pauldevine/pico_v9k/hardware/Victor9K_pga2350.kicad_pcb

## KiCad design hardware/Victor9K_pga2350.kicad_pcb (2026-02-09)

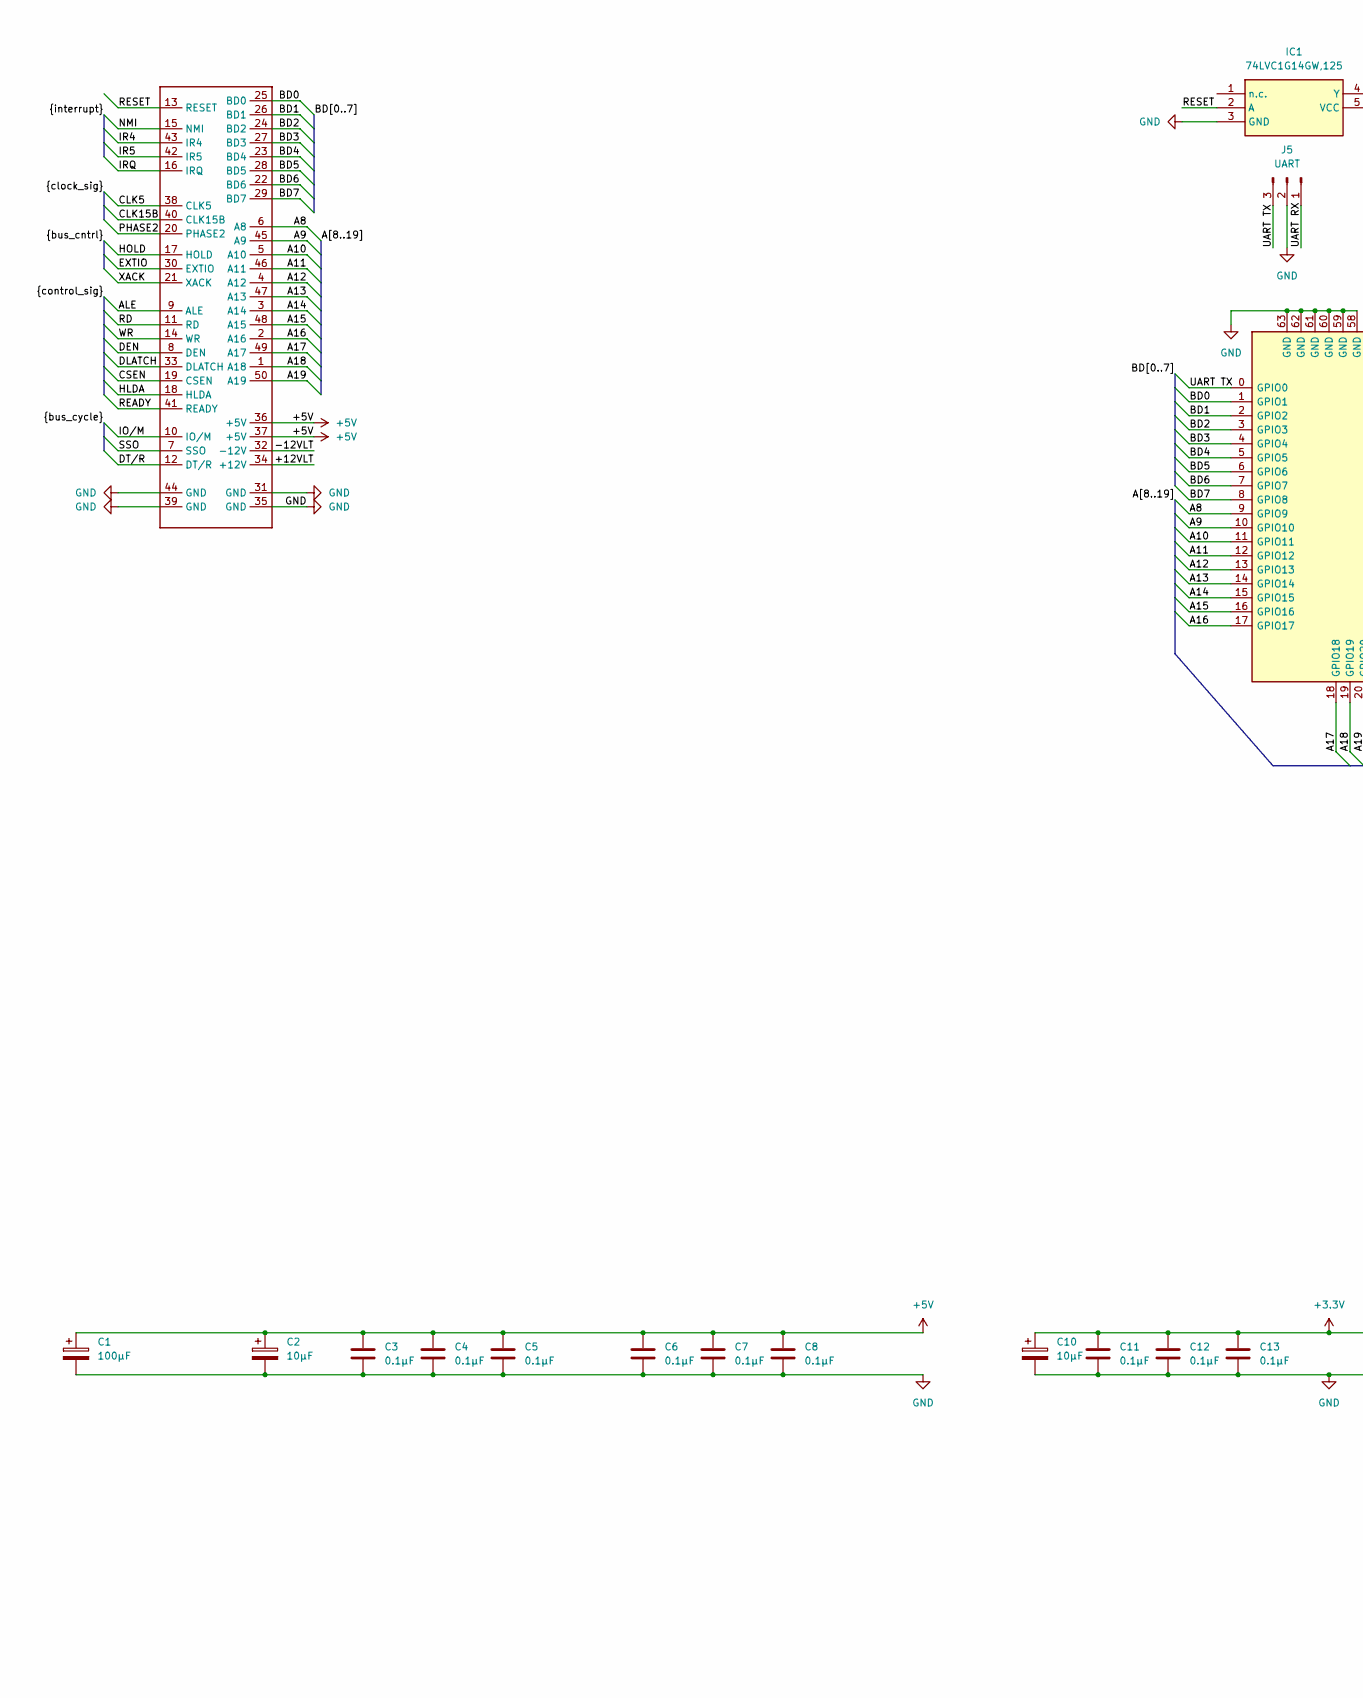
[picture p1: schematic Victor9K_pga2350.kicad_sch, part in row 1, column 1]

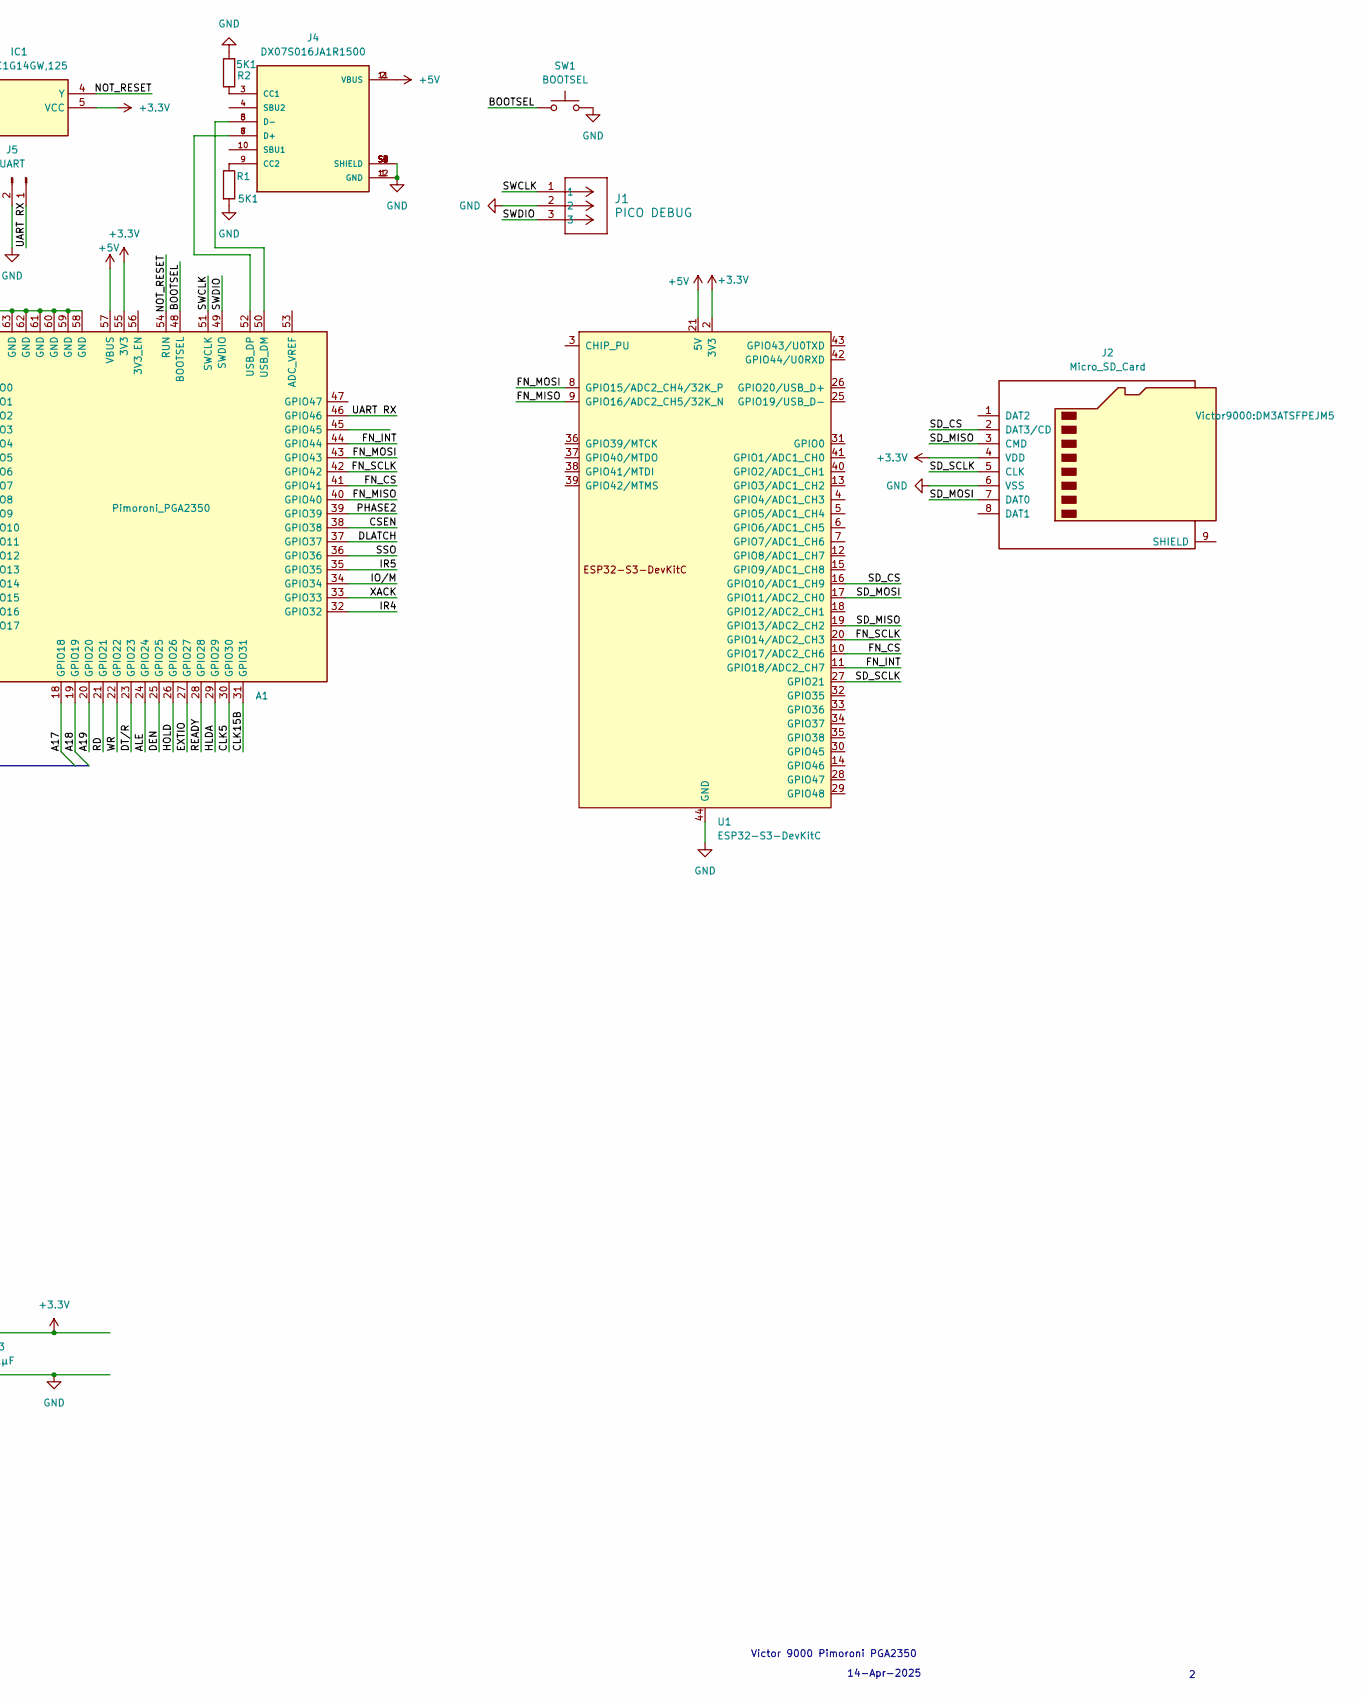
[picture p2: schematic Victor9K_pga2350.kicad_sch, part in row 1, column 2]

Parts:
A1: Pimoroni_PGA2350; pimoroni_pga2350
C1: 100µF; CP_Axial_L11.0mm_D8.0mm_P15.00mm_Horizontal
C2, C10: 10µF; C_Disc_D5.0mm_W2.5mm_P5.00mm
C3, C4, C5, C6, C7, C8, C11, C12, C13: 0.1µF; C_Disc_D5.0mm_W2.5mm_P5.00mm
GF1: Victor 9K Expansion Port; Victor_Gold_Fingers_3
IC1: 74LVC1G14GW,125; SOT65P212X110-5N; Mouser Part Number 771-74LVC1G14GW-G
J1: PICO DEBUG; CONN_BM03B-SRSS-TBLFSN_JST
J2: Micro_SD_Card; DM3ATSFPEJM5
J4: DX07S016JA1R1500; JAE_DX07S016JA1R1500; PARTREV 1; JLCPCB Part # C3197885
J5: UART; PinHeader_1x03_P2.54mm_Vertical
R1, R2: 5K1; R_Axial_DIN0204_L3.6mm_D1.6mm_P5.08mm_Horizontal
SW1: BOOTSEL; B3FS1010P
U1: ESP32-S3-DevKitC

Connections:
+3.3V: A1.55 (3V3), C10.1, C11.1, C12.1, C13.1, IC1.5 (VCC), J2.4 (VDD), U1.1 (3V3), U1.2 (3V3)
+5V: A1.57 (VBUS), C1.1, C2.1, C3.1, C4.1, C5.1, C6.1, C7.1, C8.1, GF1.36 (+5V), GF1.37 (+5V), J4.2 (VBUS), J4.11 (VBUS), U1.21 (5V)
/+12VLT: GF1.34 (+12V)
/-12VLT: GF1.32 (-12V)
/A8: A1.9 (GPIO9), GF1.6 (A8)
/A9: A1.10 (GPIO10), GF1.45 (A9)
/A10: A1.11 (GPIO11), GF1.5 (A10)
/A11: A1.12 (GPIO12), GF1.46 (A11)
/A12: A1.13 (GPIO13), GF1.4 (A12)
/A13: A1.14 (GPIO14), GF1.47 (A13)
/A14: A1.15 (GPIO15), GF1.3 (A14)
/A15: A1.16 (GPIO16), GF1.48 (A15)
/A16: A1.17 (GPIO17), GF1.2 (A16)
/A17: A1.18 (GPIO18), GF1.49 (A17)
/A18: A1.19 (GPIO19), GF1.1 (A18)
/A19: A1.20 (GPIO20), GF1.50 (A19)
/ALE: A1.24 (GPIO24), GF1.9 (ALE)
/BD0: A1.1 (GPIO1), GF1.25 (BD0)
/BD1: A1.2 (GPIO2), GF1.26 (BD1)
/BD2: A1.3 (GPIO3), GF1.24 (BD2)
/BD3: A1.4 (GPIO4), GF1.27 (BD3)
/BD4: A1.5 (GPIO5), GF1.23 (BD4)
/BD5: A1.6 (GPIO6), GF1.28 (BD5)
/BD6: A1.7 (GPIO7), GF1.22 (BD6)
/BD7: A1.8 (GPIO8), GF1.29 (BD7)
/BOOTSEL: A1.48 (BOOTSEL), SW1.1
/CLK5: A1.30 (GPIO30), GF1.38 (CLK5)
/CLK15B: A1.31 (GPIO31), GF1.40 (CLK15B)
/CSEN: A1.38 (GPIO38), GF1.19 (CSEN)
/DEN: A1.25 (GPIO25), GF1.8 (DEN)
/DLATCH: A1.37 (GPIO37), GF1.33 (DLATCH)
/DT/R: A1.23 (GPIO23), GF1.12 (DT/R)
/EXTIO: A1.27 (GPIO27), GF1.30 (EXTIO)
/FN_CS: A1.41 (GPIO41), U1.10 (GPIO17/ADC2_CH6)
/FN_INT: A1.44 (GPIO44), U1.11 (GPIO18/ADC2_CH7)
/FN_MISO: A1.40 (GPIO40), U1.9 (GPIO16/ADC2_CH5/32K_N)
/FN_MOSI: A1.43 (GPIO43), U1.8 (GPIO15/ADC2_CH4/32K_P)
/FN_SCLK: A1.42 (GPIO42), U1.20 (GPIO14/ADC2_CH3)
/HLDA: A1.29 (GPIO29), GF1.18 (HLDA)
/HOLD: A1.26 (GPIO26), GF1.17 (HOLD)
/IO/M: A1.34 (GPIO34), GF1.10 (IO/M)
/IR4: A1.32 (GPIO32), GF1.43 (IR4)
/IR5: A1.35 (GPIO35), GF1.42 (IR5)
/IRQ: GF1.16 (IRQ)
/NMI: GF1.15 (NMI)
/NOT_RESET: A1.54 (RUN), IC1.4 (Y)
/PHASE2: A1.39 (GPIO39), GF1.20 (PHASE2)
/RD: A1.21 (GPIO21), GF1.11 (RD)
/READY: A1.28 (GPIO28), GF1.41 (READY)
/RESET: GF1.13 (RESET), IC1.2 (A)
/SD_CS: J2.2 (DAT3/CD), U1.16 (GPIO10/ADC1_CH9)
/SD_MISO: J2.3 (CMD), U1.19 (GPIO13/ADC2_CH2)
/SD_MOSI: J2.7 (DAT0), U1.17 (GPIO11/ADC2_CH0)
/SD_SCLK: J2.5 (CLK), U1.27 (GPIO21)
/SSO: A1.36 (GPIO36), GF1.7 (SSO)
/SWCLK: A1.51 (SWCLK), J1.1
/SWDIO: A1.49 (SWDIO), J1.3
/UART RX: A1.46 (GPIO46), J5.1
/UART TX: A1.0 (GPIO0), J5.3
/WR: A1.22 (GPIO22), GF1.14 (WR)
/XACK: A1.33 (GPIO33), GF1.21 (XACK)
GND: A1.58 (GND), A1.59 (GND), A1.60 (GND), A1.61 (GND), A1.62 (GND), A1.63 (GND), C1.2, C2.2, C3.2, C4.2, C5.2, C6.2, C7.2, C8.2, C10.2, C11.2, C12.2, C13.2, GF1.31 (GND), GF1.35 (GND), GF1.39 (GND), GF1.44 (GND), IC1.3 (GND), J1.2, J2.6 (VSS), J4.1 (GND), J4.12 (GND), J4.S1 (SHIELD), J4.S2 (SHIELD), J4.S3 (SHIELD), J4.S4 (SHIELD), J4.S5 (SHIELD), J4.S6 (SHIELD), J5.2, R1.2, R2.2, SW1.2, U1.22 (GND), U1.23 (GND), U1.24 (GND), U1.44 (GND)
unnamed: A1.50 (USB_DM), J4.5 (D-), J4.8 (D-)
unnamed: A1.52 (USB_DP), J4.6 (D+), J4.7 (D+)
unnamed: J4.3 (CC1), R2.1
unnamed: J4.9 (CC2), R1.1

Notes on the sheet:
14-Apr-2025
Victor 9000 Pimoroni PGA2350

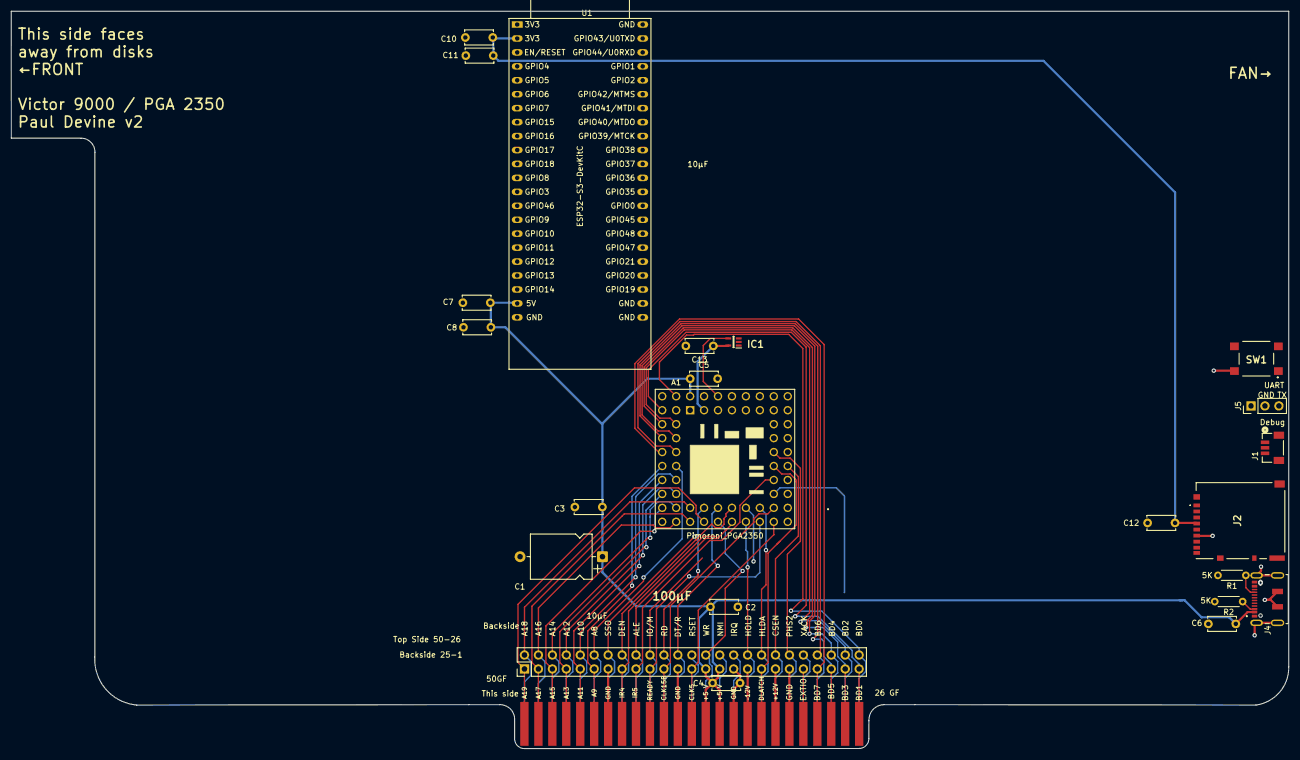
[picture p3: board Victor9K_pga2350.kicad_pcb from above]

Board: 4 copper layers, 232.7 x 134.3 mm, 23 parts (0 on the bottom side), 62 nets.
