pauldevine/pico_v9k/software/pico_victor/register_irq_handlers.c

/*
 * irq_handlers.c - Ultra-optimized cached DMA register handler
 *
 * This implementation returns cached values immediately to meet the 200ns timing
 * requirement, then enqueues register operations for deferred processing.
 */

#include "pico/stdlib.h"
#include "hardware/structs/systick.h"
#include "hardware/sync.h"  // For __dmb() memory barrier
#include <stdio.h>
#include <string.h>
#include "dma.h"
#include "sasi.h"
#include "reg_queue_processor.h"
#include "logging.h"
#include "register_irq_handlers.h"
#include "fifo_helpers.h"



// External cache and queue instances from dma_defer.h - place in time_critical section for fast access
extern defer_queue_t defer_queue;
extern cached_registers_t cached_regs;

// PIO FSTAT bit for checking if the register SM's RX FIFO is empty.
// Bit (PIO_FSTAT_RXEMPTY_LSB + N) is 1 when SM N's RX FIFO is empty.
#define REG_FIFO_RXEMPTY_BIT (1u << (PIO_FSTAT_RXEMPTY_LSB + REG_SM_CONTROL))

#ifndef REG_IRQ_FAST_TRACE_ENABLE
#define REG_IRQ_FAST_TRACE_ENABLE 1
#endif

#ifndef REG_IRQ_WARN_ENABLE
#define REG_IRQ_WARN_ENABLE 0
#endif

// Diagnostic counters (declared extern in register_irq_handlers.h)
volatile uint32_t isr_call_count = 0;
volatile uint32_t isr_fifo_entries_count = 0;
volatile uint32_t isr_tx_fifo_full_count = 0;
volatile uint32_t isr_post_status_phase_count = 0;
volatile bool status_phase_flag = false;

// Status-phase breakdown counters
volatile uint32_t diag_status_reads = 0;
volatile uint32_t diag_data_reads = 0;
volatile uint32_t diag_other_reads = 0;
volatile uint32_t diag_writes = 0;
volatile uint32_t diag_last_phase = 0;

// Safe PIO TX FIFO put: skip if full (ISR must never block).
// Increments isr_tx_fifo_full_count on overflow for diagnostics.
static inline void pio_sm_put_isr_safe(PIO pio, uint sm, uint32_t data) {
    if (pio_sm_is_tx_fifo_full(pio, sm)) {
        isr_tx_fifo_full_count++;
        return;
    }
    pio_sm_put(pio, sm, data);
}

#if REG_IRQ_WARN_ENABLE
#define reg_irq_warn(...) fast_log(__VA_ARGS__)
#else
#define reg_irq_warn(...) ((void)0)
#endif

#define REG_IRQ_TRACE_SIZE 128u
#define REG_IRQ_TRACE_MASK (REG_IRQ_TRACE_SIZE - 1u)

enum {
    REG_IRQ_TRACE_ANOM_STATUS_DATA = 0x01u,
    REG_IRQ_TRACE_ANOM_MSG_DATA    = 0x02u,
};

typedef struct {
    uint32_t seq;
    uint8_t status_before;
    uint8_t data_before;
    uint8_t status_after;
    uint8_t data_after;
    uint8_t bus_ctrl;
    uint8_t flags;
    uint8_t reserved;
} reg_irq_trace_entry_t;

typedef struct {
    volatile uint32_t head;
    volatile uint32_t seq;
    volatile uint32_t anomaly_count;
    reg_irq_trace_entry_t entries[REG_IRQ_TRACE_SIZE];
} reg_irq_trace_t;

static reg_irq_trace_t reg_irq_trace __attribute__((section(".time_critical.reg_irq_trace")));
static uint32_t reg_irq_trace_last_dumped_anomaly = 0;

static inline uint8_t reg_irq_trace_anomaly_flags(uint8_t status_before, uint8_t data_before) {
    uint8_t flags = 0;
    uint8_t phase = status_before & (SASI_CTL_BIT | SASI_INP_BIT | SASI_MSG_BIT);

    // In status and message phases, host must read 0x00 from DATA for this implementation.
    if (phase == (SASI_CTL_BIT | SASI_INP_BIT) && data_before != 0x00) {
        flags |= REG_IRQ_TRACE_ANOM_STATUS_DATA;
    } else if (phase == (SASI_CTL_BIT | SASI_INP_BIT | SASI_MSG_BIT) && data_before != 0x00) {
        flags |= REG_IRQ_TRACE_ANOM_MSG_DATA;
    }

    return flags;
}

static inline void reg_irq_trace_record_data_commit(uint8_t status_before,
                                                    uint8_t data_before,
                                                    uint8_t status_after,
                                                    uint8_t data_after,
                                                    uint8_t bus_ctrl) {
    uint32_t idx = reg_irq_trace.head & REG_IRQ_TRACE_MASK;
    uint8_t flags = reg_irq_trace_anomaly_flags(status_before, data_before);

    reg_irq_trace.entries[idx].seq = reg_irq_trace.seq++;
    reg_irq_trace.entries[idx].status_before = status_before;
    reg_irq_trace.entries[idx].data_before = data_before;
    reg_irq_trace.entries[idx].status_after = status_after;
    reg_irq_trace.entries[idx].data_after = data_after;
    reg_irq_trace.entries[idx].bus_ctrl = bus_ctrl;
    reg_irq_trace.entries[idx].flags = flags;
    reg_irq_trace.entries[idx].reserved = 0;
    reg_irq_trace.head++;

    if (flags) {
        reg_irq_trace.anomaly_count++;
    }
}

void register_irq_trace_init(void) {
    memset(&reg_irq_trace, 0, sizeof(reg_irq_trace));
    reg_irq_trace_last_dumped_anomaly = 0;
}

uint32_t register_irq_trace_anomaly_count(void) {
    return reg_irq_trace.anomaly_count;
}

void register_irq_trace_dump(const char *reason) {
    uint32_t head = reg_irq_trace.head;
    uint32_t count = (head > REG_IRQ_TRACE_SIZE) ? REG_IRQ_TRACE_SIZE : head;
    uint32_t start = head - count;

    if (reason && reason[0]) {
        printf("\n=== FAST IRQ DATA TRACE (%s) ===\n", reason);
    } else {
        printf("\n=== FAST IRQ DATA TRACE ===\n");
    }
    printf("entries=%lu anomalies=%lu\n",
           (unsigned long)count, (unsigned long)reg_irq_trace.anomaly_count);
    printf("Seq   S0  D0  S1  D1  BC  Flg\n");
    printf("----  --  --  --  --  --  ---\n");

    for (uint32_t i = 0; i < count; i++) {
        uint32_t idx = (start + i) & REG_IRQ_TRACE_MASK;
        const reg_irq_trace_entry_t *e = &reg_irq_trace.entries[idx];
        printf("%4lu  %02X  %02X  %02X  %02X  %02X  %02X\n",
               (unsigned long)e->seq,
               e->status_before,
               e->data_before,
               e->status_after,
               e->data_after,
               e->bus_ctrl,
               e->flags);
    }
    printf("=== END FAST IRQ DATA TRACE ===\n\n");

    reg_irq_trace_last_dumped_anomaly = reg_irq_trace.anomaly_count;
}

void register_irq_trace_note_reset(const char *reason) {
#if !REG_IRQ_FAST_TRACE_ENABLE
    (void)reason;
    return;
#else
    if (reg_irq_trace.anomaly_count == 0) {
        return;
    }
    if (reg_irq_trace.anomaly_count == reg_irq_trace_last_dumped_anomaly) {
        return;
    }
    register_irq_trace_dump(reason);
#endif
}

static inline bool is_valid_reg_offset(uint32_t masked_offset) {
    switch (masked_offset & 0xFFu) {
        case REG_CONTROL:
        case REG_DATA:
        case REG_STATUS:
        case 0x30:
        case REG_ADDR_L:
        case REG_ADDR_M:
        case REG_ADDR_H:
            return true;
        default:
            return false;
    }
}

static inline void clear_irq_on_status_read(dma_registers_t *dma) {
    if (!dma->state.interrupt_pending) {
        return;
    }
    dma->state.interrupt_pending = 0;
    gpio_put(DMA_IRQ_PIN, DMA_IRQ_DEASSERT_LEVEL);
}




// Pre-warm caches by touching critical memory locations
void init_register_irq_handlers(void) {
    // Initialize deferred processing system
    dma_defer_init();
    register_irq_trace_init();

    // Get cached registers and pre-warm
    cached_registers_t *cached = &cached_regs;
    volatile uint8_t dummy = 0;

    // Touch all cached values multiple times
    for (int iter = 0; iter < 3; iter++) {
        for (int i = 0; i < 256; i++) {
            dummy = cached->values[i];
        }
    }

    // Touch the most commonly accessed addresses
    for (int iter = 0; iter < 10; iter++) {
        dummy = cached->values[0x80];
        dummy = cached->values[0xA0];
        dummy = cached->values[0xC0];
        dummy = cached->values[0x20];
        dummy = cached->values[0x30];
    }

    // Touch critical SIO registers
    volatile uint32_t dummy32;
    dummy32 = *(volatile uint32_t *)SIO_GPIO_OUT_SET_REG;
    dummy32 = *(volatile uint32_t *)SIO_GPIO_OUT_CLR_REG;

    // Touch PIO registers
    dummy32 = PIO_REGISTERS->rxf[REG_SM_CONTROL];
    dummy32 = PIO_REGISTERS->txf[REG_SM_CONTROL];
    dummy32 = PIO_REGISTERS->fstat;

    (void)dummy;
    (void)dummy32;
}

// IRQ handler for board_registers_output handles FIFO_REG_READ
void __time_critical_func(register_read_irq_isr)() {
    static uint32_t masked_offset;

    isr_call_count++;

    // Drain all pending FIFO entries in a single ISR invocation.
    // This avoids tail-chain overhead (~30ns per re-entry) and ensures
    // write-then-read sequences respond within the 530ns timing budget.
    while (!(PIO_REGISTERS->fstat & REG_FIFO_RXEMPTY_BIT)) {
        isr_fifo_entries_count++;
        uint32_t raw_value;
        uint8_t data = 0;
        uint8_t trace_flags = 0;
        uint8_t pending_before = (uint8_t)fifo_pending_prefetch;

        // Get value from bus_output_helper PIO FIFO
        raw_value = PIO_REGISTERS->rxf[REG_SM_CONTROL];

        // Extract 2-bit payload type flag
        uint32_t payload_type = fifo_payload_type(raw_value);

        // Get cached registers pointer
        cached_registers_t *cached = &cached_regs;

        bool enque_result = false;
        switch (payload_type) {
            case FIFO_REG_PREFETCH: {
                // Prefetch cached value in case of a register read, need to respond immediately to hit timing
                uint32_t address = board_fifo_read_address(raw_value);

                if (address < DMA_REGISTER_BASE || address >= (DMA_REGISTER_BASE + 0x100)) {
                    trace_flags |= FIFO_TRACE_FLAG_ERROR;
                    fifo_trace_record(raw_value, payload_type, pending_before, (uint8_t)fifo_pending_prefetch, trace_flags, 0);
                    continue;
                }

                masked_offset = dma_mask_offset(address - DMA_REGISTER_BASE);
                masked_offset &= 0xFF;

                fifo_pending_prefetch++;
                if (!is_valid_reg_offset(masked_offset)) {
                    trace_flags |= FIFO_TRACE_FLAG_ERROR;
                    data = 0xFF;
                } else {
                    if (masked_offset == REG_DATA) {
                        uint8_t phase = cached->values[REG_STATUS] & (SASI_CTL_BIT | SASI_INP_BIT | SASI_MSG_BIT);
                        if (phase == (SASI_CTL_BIT | SASI_INP_BIT | SASI_MSG_BIT)) {
                            // Message byte is always Command Complete (0x00).
                            data = 0x00;
                            cached->values[REG_DATA] = 0x00;
                        } else if (phase == (SASI_CTL_BIT | SASI_INP_BIT)) {
                            // Serve status byte from authoritative controller state.
                            dma_registers_t *dma = &dma_registers;
                            data = dma ? dma->status : cached->values[REG_DATA];
                            cached->values[REG_DATA] = data;
                        } else {
                            data = cached->values[REG_DATA];
                        }
                    } else {
                        data = cached->values[masked_offset];
                    }
                }

                // pio outputs 8 bits of data first then 8 bits of pindirs (0xFF for output)
                uint32_t payload = (0xFF << 8) | (data & 0xFF);
                pio_sm_put_isr_safe(PIO_REGISTERS, REG_SM_CONTROL, payload);

                uint8_t pending_after = (uint8_t)fifo_pending_prefetch;
                fifo_trace_record(raw_value, payload_type, pending_before, pending_after, trace_flags, data);
                break;
            }

            case FIFO_REG_READ_COMMIT: {
                // Commit of a register read
                uint32_t address = board_fifo_read_address(raw_value);

                if (address < DMA_REGISTER_BASE || address >= (DMA_REGISTER_BASE + 0x100)) {
                    trace_flags |= FIFO_TRACE_FLAG_ERROR;
                    fifo_trace_record(raw_value, payload_type, pending_before, (uint8_t)fifo_pending_prefetch, trace_flags, 0);
                    continue;
                }

                // Default: don't enqueue reads - only DATA reads need deferred processing
                enque_result = false;

                if (fifo_pending_prefetch == 0) {
                    trace_flags |= FIFO_TRACE_FLAG_ERROR;
                    reg_irq_warn("FIFO WARN: Commit without prefetch raw=0x%08x\n", raw_value);
                } else {
                    fifo_pending_prefetch--;
                }

                // Validate the register offset
                uint32_t commit_offset = dma_mask_offset(address - DMA_REGISTER_BASE) & 0xFF;
                if (!is_valid_reg_offset(commit_offset)) {
                    trace_flags |= FIFO_TRACE_FLAG_ERROR;
                }

                // For DATA register reads, update the CACHE to reflect the next phase.
                // We check the CACHED status (not bus_ctrl) because the cache may already
                // be ahead of bus_ctrl. The cache represents what the host is seeing.
                if (commit_offset == REG_DATA) {
                    uint8_t cached_status = cached->values[REG_STATUS] & 0x1F;
#if REG_IRQ_FAST_TRACE_ENABLE
                    uint8_t cached_data_before = cached->values[REG_DATA];
#endif

                    if (cached_status & SASI_MSG_BIT) {
                        // Message phase (0x1F) - host read message byte, transition to bus free
                        cached->values[REG_DATA] = 0x00;  // Ensure message byte is 0x00
                        cached->values[REG_STATUS] = 0x00;
                        cached->values[0x30] = 0x00;
                    } else if ((cached_status & (SASI_CTL_BIT | SASI_INP_BIT)) == (SASI_CTL_BIT | SASI_INP_BIT)) {
                        // Status phase (0x0F) - host read status byte, transition to message phase
                        uint8_t next_status = cached_status | SASI_MSG_BIT;  // 0x0F -> 0x1F
                        cached->values[REG_STATUS] = next_status;
                        cached->values[0x30] = next_status;
                        cached->values[REG_DATA] = 0x00;  // Message byte = Command Complete
                    }

#if REG_IRQ_FAST_TRACE_ENABLE
                    dma_registers_t *dma = &dma_registers;
                    uint8_t bus_ctrl_snapshot = dma ? dma->bus_ctrl : 0;
                    reg_irq_trace_record_data_commit(cached_status,
                                                     cached_data_before,
                                                     cached->values[REG_STATUS] & 0x1F,
                                                     cached->values[REG_DATA],
                                                     bus_ctrl_snapshot);
#endif
                    // DATA reads need deferred processing to sync bus_ctrl
                    enque_result = true;
                } else if (commit_offset == REG_STATUS || commit_offset == 0x30) {
                    // Reading status clears the interrupt latch per DMA board spec.
                    // All work done here in fast handler - no need to enqueue.
                    dma_registers_t *dma = &dma_registers;
                    clear_irq_on_status_read(dma);
                    if (status_phase_flag) {
                        diag_status_reads++;
                        isr_post_status_phase_count++;
                    }
                }
                // Address register reads have no side effects - don't enqueue

                uint8_t pending_after = (uint8_t)fifo_pending_prefetch;
                fifo_trace_record(raw_value, payload_type, pending_before, pending_after, trace_flags, data);
                break;
            }

            case FIFO_REG_WRITE: {
                // 8088 write to DMA register
                uint32_t address = dma_fifo_write_address(raw_value);

                if (address < DMA_REGISTER_BASE || address >= (DMA_REGISTER_BASE + 0x100)) {
                    trace_flags |= FIFO_TRACE_FLAG_ERROR;
                    fifo_trace_record(raw_value, payload_type, pending_before, (uint8_t)fifo_pending_prefetch, trace_flags, 0);
                    continue;
                }

                masked_offset = dma_mask_offset(address - DMA_REGISTER_BASE);
                masked_offset &= 0xFF;

                data = dma_fifo_write_data(raw_value);
                if (masked_offset == REG_ADDR_H) {
                    data &= 0x0F;
                }
                bool valid_offset = is_valid_reg_offset(masked_offset);
                bool is_addr_reg = valid_offset &&
                                   (masked_offset == REG_ADDR_L || masked_offset == REG_ADDR_M ||
                                    masked_offset == REG_ADDR_H);
                if (!valid_offset) {
                    trace_flags |= FIFO_TRACE_FLAG_ERROR;
                }

                if (is_addr_reg) {
                    dma_registers_t *dma = &dma_registers;
                    if (masked_offset == REG_ADDR_L) {
                        dma->dma_address.bytes.low = data;
                    } else if (masked_offset == REG_ADDR_M) {
                        dma->dma_address.bytes.mid = data;
                    } else {
                        dma->dma_address.bytes.high = data & 0x0F;
                    }
                    __dmb();  // Ensure Core 0 sees updated DMA address bytes promptly
                }

                if (fifo_pending_prefetch == 0) {
                    trace_flags |= FIFO_TRACE_FLAG_ERROR;
                    reg_irq_warn("FIFO WARN: Reg Write without prefetch raw=0x%08x\n", raw_value);
                } else {
                    fifo_pending_prefetch--;
                }

                if (masked_offset == REG_CONTROL) {
                    uint8_t prev_ctrl = cached->values[REG_CONTROL];
                    bool prev_sel = (prev_ctrl & DMA_SELECT_BIT) != 0;
                    bool now_sel = (data & DMA_SELECT_BIT) != 0;

                    if (data & DMA_RESET_BIT) {
                        // Signal Core 1 to abort any in-flight command immediately
                        dma_registers_t *dma = &dma_registers;
                        dma->reset_requested = true;
                        __dmb();
                        // RESET overrides all other CONTROL bits.
                        // Clear cache to bus-free immediately so the host
                        // sees idle state while Core 1 processes the reset.
                        cached->values[REG_STATUS] = 0x00;
                        cached->values[0x30] = 0x00;
                        cached->values[REG_DATA] = 0x00;
                    } else if (now_sel && !prev_sel) {
                        cached->values[REG_STATUS] = SASI_BSY_BIT;
                        cached->values[0x30] = SASI_BSY_BIT;
                        cached->values[REG_DATA] = 0x00;
                    } else if (!now_sel && prev_sel) {
                        uint8_t cmd_phase = SASI_BSY_BIT | SASI_REQ_BIT | SASI_CTL_BIT;
                        cached->values[REG_STATUS] = cmd_phase;
                        cached->values[0x30] = cmd_phase;
                        cached->values[REG_DATA] = 0x00;
                    }
                }

                if (valid_offset) {
                    cached->values[masked_offset] = data;
                    if (masked_offset == REG_STATUS) {
                        cached->values[0x30] = data;
                    }
                }
                trace_flags |= FIFO_TRACE_FLAG_WRITE;

                uint8_t pending_after = (uint8_t)fifo_pending_prefetch;
                fifo_trace_record(raw_value, payload_type, pending_before, pending_after, trace_flags, data);
                enque_result = valid_offset && !is_addr_reg;
                break;
            }

            default:
                trace_flags |= FIFO_TRACE_FLAG_ERROR;
                fifo_trace_record(raw_value, payload_type, pending_before, (uint8_t)fifo_pending_prefetch, trace_flags, 0);
                continue;
        }

        if (enque_result) {
            // Enqueue for deferred processing (fast inline version)
            defer_queue_t *queue = &defer_queue;
            uint32_t head = queue->head;
            uint32_t next = (head + 1) & DEFER_QUEUE_MASK;

            if (next != queue->tail) {
                queue->entries[head].raw_value = raw_value;
                __asm volatile("dmb" ::: "memory");
                queue->head = next;
            } else {
                // Queue full - track dropped entries
                queue->drops++;
            }
        }
    }
}

// Legacy entry point used by cache warmup; delegate to unified handler
void __time_critical_func(register_write_irq_isr)() {
    register_read_irq_isr();
}
