pauldevine/pico_v9k/(commit log)

2025-09-15 SPI-backed disk reads
2025-09-15 added Write(6), Request Sense, and Mode Select handlers and the SPI write plumbing
2025-09-15 added on-device test harness
2025-09-21 cleaning up SPI handshaking
2025-09-21 cleaning up SPI interface, fixing mount process
    [on_device_runner.c, spi.c, spi.h]
2025-09-22 increase SPI timeout to account for slow actions like disk mounting
2025-09-25 cleaning up UART for actual hardware
2025-09-26 updating pico code to correctly handle LBA
    [dma.c, sasi.c]
2025-09-27 fixing some initialization timing errors
    [dma_board.c]
2025-09-28 adding timing debug pin
2025-10-03 removed 74LVC245 from test dma diagnostic
2025-10-07 fixing some missed pin defition updates
2025-10-10 initial version that's moved HOLD to a side-set pin
2025-10-11 continuing to iterate on fixing pio / gpio routing and wait pin visibility issues
2025-10-11 calling gpio_set_function() in our read pin setup
2025-10-13 added short test for HOLD HLDA hardware exercise
    [clock_simulator.c, clock_simulator.h, test_clock_sideset.c]
2025-10-13 first version that has a READ success. Changed output for A8-A19 stability during T3
    [test_dma_cleaned.c]
2025-10-13 moving all the code to 2 FIFO entries per DMA call
2025-10-14 fixed state machine change from separate wr/rd instances to one common sm
    [dma.c, dma.h, dma_board.c, sasi.c]
2025-10-14 updated board_registers.pio for new pin layout on 74LVC245-free naked rp2350 board
2025-10-14 updated pio instance handling for registers and dma_read_write to switch functions between usage
2025-10-15 cleaned up register / dma handoff
2025-10-17 before deferring work for faster register access, reads currently failing
    [dma.c, dma.h, dma_board.c]
2025-10-17 initial version of dma_board_cached, adjusted pio RD cycle hold time, first time victor sees some data correctly. still big timing issue with PIO
    [dma.c, dma.h, dma_board.c, dma_defer.c, dma_defer.h]
2025-10-19 reworked board_registers.pio and FIFO protocol entirely
    [dma.c, dma.h, dma_board.c, dma_defer.c, dma_defer.h]
2025-10-25 before giving up on GPIO0, moving UART TX back to gpio0
2025-10-26 dma_read_write pio sm disabled, have hardcoded output from board_registers appearing on data pins bd0-bd7
2025-11-01 continued playing with debuging pin output
2025-11-04 trying to extend RD sample on extio.pio to resolve timing race condition
2025-11-05 first time passing all tests, lowere GPIO_DRIVE_STRENGTH to 2MA, added delay to board_registers
2025-11-05 removed HOLD as debug pin so I can restore dma_read_write
2025-11-08 created IO/M helper to free up a lower 32 pin
2025-11-08 Implement three-way PIO state machine coordination via IRQs
    Fixed interprocess communication between board_registers, dma_read_write,
    and bus_output_helper to properly coordinate BD0-A19 GPIO access:
    - bus_output_helper.pio: Added HLDA JMP pin config, configured OUT pins
    for BD0-A19, and proper initialization for all 20 bus pins
    - board_registers.pio: Added wait for READY signal (800ns window) before
    signaling IRQ 1 to give ARM time to push data; changed to IRQ 4 for
    cycle completion
    - dma_read_write.pio: Delegated data read to bus_output_helper via IRQ 3;
    changed to IRQ 4 for cycle completion
    IRQ protocol now clearly defined:
    - IRQ 1: Data ready, start outputting
    - IRQ 2: T1→T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
2025-11-08 Add comprehensive PIO state machine coordination diagrams
    Created detailed mermaid sequence diagrams showing T-state timing and
    signaling between board_registers, dma_read_write, and bus_output_helper
    state machines.
    Diagrams cover:
    - Register read cycles (8088 reading from 0xEF300)
    - DMA read cycles (Pico reading from 8088 memory)
    - DMA write cycles (Pico writing to 8088 memory)
    Each diagram shows all T0-T4 states, FIFO operations, IRQ signaling,
    and pin state changes. Includes summary tables for IRQ and FIFO protocols.
2025-11-08 Add comprehensive ARM-PIO integration analysis for bus_output_helper
    Detailed analysis of required ARM-side code changes to support the new
    three-state-machine PIO architecture.
    Key findings:
    - ARM IRQ handlers must push register read responses to bus_output_helper
    TX FIFO instead of board_registers TX FIFO
    - 800ns READY timing window is sufficient for ARM response (~750-850ns)
    - Need to initialize bus_output_helper SM and preload pindirs value
    - Changes required in dma.c, dma_ultra_fast.c, dma_board.c, and dma.h
    Includes:
    - Exact code change locations with line numbers
    - Timing analysis and diagrams
    - PIO resource allocation table
    - 5-phase testing strategy
    - Risk assessment and mitigat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
2025-11-08 Implement ARM-side integration for bus_output_helper architecture
    Modified ARM code to push register read responses to bus_output_helper
    TX FIFO instead of board_registers TX FIFO, enabling the three-state-
    machine coordination architecture.
    Changes:
    - dma.h: Added PIO_BUS_HELPER and BUS_HELPER_SM defines, added
    bus_helper accessor function prototypes
    - dma.c: Implemented bus_helper accessor functions (get/set PIO/SM),
    modified standard IRQ handler to push register reads to bus_helper
    - dma_ultra_fast.c: Modified both ultra-fast IRQ handlers (standard
    and _asm variant) to push to bus_helper instead of board_registers
    - dma_board.c: Added bus_output_helper.pio.h include, initialized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
2025-11-08 Fix cached IRQ handlers to push data to bus_output_helper FIFO
    Both registers_irq_handler_cached() and registers_irq_handler_cached_asm()
    were pushing register read data to PIO_REGISTERS (board_registers SM)
    instead of bus_output_helper SM. This caused register reads to fail
    when using dma_board_cached target.
    - Updated both handlers to use dma_get_bus_helper_pio() and
    dma_get_bus_helper_sm() to get the correct PIO and SM
    - Changed data format from (0xFF00 | data) to (uint32_t)(data & 0xFFu)
    to match bus_output_helper's expected format (just the data byte)
    This matches the fixes previously made to the standard handlers in
    dma.c and dma_ultra_fast.c.
    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
2025-11-10 Fix board_registers payload address extraction to match PIO format
    The board_registers.pio state machine uses right-shift ISR config,
    which places the 20-bit address in bits [29:10] with the 2-bit payload
    type in bits [31:30]. The helper functions were incorrectly extracting
    from bits [19:0].
    - Fix dma_fifo_prefetch_address() to extract from bits [29:10]
    - Fix dma_fifo_commit_address() to extract from bits [29:10]
    - Replace manual extraction in dma_defer.c with helper function
    This ensures payload decoding matches the PIO encoding:
    - PREFETCH (0x00): [type:31-30][addr:29-10][zeros:9-0]
    - COMMIT (0x01): [type:31-30][addr:29-10][zeros:9-0]
    - WRITE (0x02): [type:31-30][data:29-2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
    [dma.h, dma_defer.c]
2025-11-10 Fix WRITE payload address extraction to match board_registers format
    The board_registers.pio WRITE path performs two right-shifts on the ISR:
    1. Line 66: in pins, 8 -> shifts right by 8 (data inserted at top)
    2. Line 67: in x, 2 -> shifts right by 2 (type inserted at top)
    This places the 20-bit address in bits [19:0], NOT [21:2] as previously
    assumed. The address that was originally at bits [29:10] in the PREFETCH
    format gets shifted down by 10 positions total during WRITE encoding.
    Evidence from debug log:
    raw=0x87cef3a0 -> bits[19:0]=0xEF3A0 (correct address)
    -> bits[29:22]=0x1F (data value)
    -> bits[31:30]=0b10 (WRITE type)
    - Fix dma_fif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
    [dma.h]
2025-11-10 Revert WRITE payload to correct format after board_registers.pio fix
    The addition of `mov isr, osr` at board_registers.pio:66 changes the
    WRITE payload format by restoring the original address position before
    the data and type shifts occur.
    With line 66 fix, WRITE path is:
    1. Line 66: mov isr, osr -> ISR = [addr:31-12][zeros:11-0]
    2. Line 67: in pins, 8 -> ISR = [data:31-24][addr:23-4][zeros:3-0]
    3. Line 68: in x, 2 -> ISR = [10:31-30][data:29-22][addr:21-2][zeros:1-0]
    This places address at bits [21:2], NOT [19:0] as in my previous commit.
    The original helper functions were actually correct.
    Reverting to:
    - dma_fifo_write_address(): Extract from bits [21:2]
    - dma_fifo_encode_write()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
    [dma.h]
2025-11-10 Fix PREFETCH/COMMIT address extraction in trace analyzer
    The analyzer was extracting addresses from bits [19:0] instead of [29:10],
    matching the same bug that was in the C helper functions. This caused false
    'out-of-range' anomaly reports.
    - PREFETCH: Extract address from bits [29:10] (was bits [19:0])
    - COMMIT: Extract address from bits [29:10] (was bits [19:0])
    - WRITE: Already correct at bits [21:2]
    This matches the corrected dma.h helper functions and board_registers.pio
    payload format with right-shift ISR configuration.
    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
    [fifo_trace_analyzer.py]
2025-11-11 reworked bus_output_helper.pio, renamded board_regsiters.pio program identifier. WIP
    [dma.c, dma_board.c, register_test.c]
2025-11-11 Restructure IRQ handlers for separate PIO programs
    Created separate IRQ handler functions for board_registers and
    bus_output_helper PIO programs to align with the new PIO organization
    where each PIO handles specific payload types:
    - board_registers_irq_handler_cached_asm(): Handles WRITE_VALUE payloads
    from board_registers (PIO0/SM0)
    - bus_output_helper_irq_handler_cached_asm(): Handles PREFETCH payloads
    (register reads) and DMA_READ payloads from bus_output_helper (PIO1/SM0)
    Updated dma_cached.c to register both handlers on their respective PIO IRQs
    (PIO0_IRQ_0 and PIO1_IRQ_0), with separate warmup sequences for each.
    This separation improves code clarity and aligns the ARM code wit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
2025-11-11 Remove push instructions from board_registers.pio T3_READ
    The new IRQ handler architecture splits responsibilities:
    - board_registers handler: Only processes WRITE_VALUE payloads
    - bus_output_helper handler: Processes PREFETCH and DMA_READ payloads
    This change removes the PREFETCH and READ_COMMIT push instructions
    from board_registers.pio T3_READ section, so board_registers only
    pushes WRITE_VALUE payloads from T3_WRITE. The PREFETCH push now
    happens exclusively in bus_output_helper.pio T3_READ_REG.
    Fixes runtime errors where unexpected PREFETCH (0x00) and READ_COMMIT
    (0x01) payloads were arriving at the board_registers handler.
2025-11-12 Fix remaining payload flag inconsistencies
    This commit addresses the last inconsistencies in the payload flag
    refactoring from the old PREFETCH/COMMIT two-phase protocol to the
    new single-phase REG_READ protocol.
    - dma.h: Fix board_fifo_encode_read() to use FIFO_REG_READ (0x00)
    instead of FIFO_DMA_READ (0x02)
    - dma.h: Remove obsolete dma_fifo_commit_address() function
    - dma_defer.c: Change from dma_fifo_commit_address() to
    board_fifo_read_address()
    - dma_defer.c: Update comment to reflect correct payload type (00)
    - dma_ultra_fast_cached.c: Update log message from "PREFETCH" to
    "REG_READ"
    - board_registers.pio: Update comments to use "REG_READ" and
    "WRITE_VALUE" terminology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
    [dma.h, dma_defer.c, fifo_trace_analyzer.py]
2025-11-14 added missing .h gaurds
    [sasi.h]
2025-11-14 fixed payload mapping, clarified method naming, cleaned up pio FIFO relationships, fixed bus_ouput_helper missing initialization
    [debug_queue.c, dma.c, dma.h, dma_board.c, spi.h]
2025-11-14 Fix sideset pin initialization order in bus_output_helper
    The sideset pin (HOLD_PIN) was not appearing on logic analyzer because
    GPIO initialization was happening before pio_sm_init(), which resets
    the state machine and clears pin configurations.
    - Move all GPIO initialization (pio_gpio_init, pin values, pindirs) to
    occur AFTER pio_sm_init() is called
    - Add missing sm_config_set_in_pins() configuration for address bus reads
    - Reorganize initialization to follow SDK best practices:
    1. Configure sm_config
    2. Call pio_sm_init()
    3. Initialize GPIOs
    4. Enable SM
    This ensures sideset pin is properly configured and will toggle on
    logic analyzer as expected.
    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
2025-11-16 fixing output challneges with board_registers_output timing and pindirs
    [register_irq_handlers.c]
2025-11-27 removed debugging side-set HOLD from board_registers_output.pio
2025-11-29 first version that actually started a DMA transfer on the real hardware. still some subtle timing bug on the registers
    [default.cfg, victor9k.cfg]
2025-12-06 WIP iterating on getting DMA working in new both active setup, removing HOLD as side-set debug pin, not working yet
    [victor9k.cfg]
2025-12-07 debugging DMA write, fixed missing .wrap_target in dma_rw_control, adjusted some T cycle timing
    [dma.c, dma.h, dma_board.c, register_cache.c, test_pio_simple.c]
2025-12-18 fixing miscellaneous bugs related to dma pio handling
    [dma.h, dma_board.c, register_cache.c]
2025-12-24 fixes a few timing related bugs in the pio code
    [dma.c, dma_board.c]
2025-12-24 initial start rewiring things to old pio with new arm
2025-12-25 second miletone after rewiring old pio with new arm, cleaned up compilation errors. still WIP and untested.
    [dma.c, dma.h, dma_board.c, dma_irq_handler.c, reg_queue_processor.c, register_cache.c, register_irq_handlers.c]
2025-12-27 debugging after big rewrite, fixed some gpio initialization, pio logic, payload values
    [dma.c, dma.h, dma_irq_handler.c, fifo_helpers.h, reg_queue_processor.c, register_cache.c, register_irq_handlers.c]
2025-12-31 added some volatiles, additional debugs, attempting to fix boot process
    [dma.h, dma_board.c, reg_queue_processor.c, register_cache.c, register_irq_handlers.c, sasi.c]
2026-01-07 Improve SASI command/status phase handshaking and register synchronization
    SASI Protocol Improvements:
    - Add configurable command execution delay (SASI_COMMAND_DELAY_US = 85ms) to
    simulate controller processing time between command and data phases
    - Fix REQ/ACK handshaking: properly drop REQ when acknowledging bytes and
    clear ACK before entering new phases
    - Correct bus status during DMA transfers: keep BSY|CTL (command busy)
    instead of incorrectly indicating data-in/data-out phases
    - Clear status_pending and non_dma_req flags on proper state transitions
    Register Handler Improvements:
    - Add is_valid_reg_offset() validation to flag invalid register accesses
    - Implement clear_irq_on_sta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
    [dma.c, dma_irq_handler.c, fifo_helpers.h, fifo_trace_analyzer.py, reg_queue_processor.c, reg_queue_processor.h, register_irq_handlers.c]
2026-01-19 cleaning up hardware for new layout
    [Victor9K_pga2350.kicad_pcb, Victor9K_pga2350.kicad_sch]
2026-01-27 first version that Victor tried to boot from. adjusted SASI state machine to better handle state transitions between the cache and the deferred worker. also adjusted for Victor's expectations of the 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
2026-01-27 initial version of re-worked hardware removing the 74LVC245's
    [Victor9K_pga2350.kicad_pcb, Victor9K_pga2350.kicad_sch]
2026-01-29 falling back to SD card implementation to simplify debugging. partially working DMA recovered version
2026-01-30 first version to successfully boot, only to onboard motherboard RAM, doesn't work with expansion RAM
    [analyze_dma_capture.py, dma.c, dma.h, sasi.h]
2026-01-31 first version passing dma_verify.c test. fixed double push on DMA RD path and removed bunch of logging
    [dma.c, dma_board.c, register_irq_handlers.c, sasi.c, sd_storage.c]
2026-02-09 fix SASI phase handling, DMA batch bounds, and add diagnostic tracing
    - Fix command phase detection to check CTL+INP+MSG bits (not just CTL),
    preventing command bytes from being processed during status/message phases
    - Add data-out phase support for 0x0C Set Drive Params (DMA and non-DMA paths)
    - Fix DMA read/write batch processing: ceiling division, bounds checks,
    free temp buffer on early return
    - Add proper DATA IN/OUT bus phase transitions during sector read/write
    - Fix Request Sense to return 4-byte SASI format instead of 18-byte SCSI
    - Prevent host DATA writes from leaking into cached REG_DATA (status/message)
    - Add phase-aware DATA register reads in fast ISR path
    - Add SASI trace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
    [dma.c, dma.h, dma_board.c, reg_queue_processor.c, register_irq_handlers.c, register_irq_handlers.h, sasi.c, sasi.h]
2026-02-10 Reduce ISR latency jitter for register read path
    Replace dma_get_registers() lazy-init function with a global
    dma_registers placed in __scratch_x RAM, eliminating function call
    overhead and potential XIP cache misses from the time-critical ISR.
    Remove defer_get_queue() and defer_get_cached_registers() accessor
    functions — callers now use the globals directly.
    Cache DATA register writes unconditionally (matching MAME behavior)
    so write-then-read card detection works correctly.
    Additional cleanups: disable FIFO trace and SASI trace autodump by
    default to avoid timing-critical UART overhead, guard fast_log
    warnings behind REG_IRQ_WARN_ENABLE, strip verbose polling loop
    from dma_board main l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
    [benchmark_irq.c, dma.c, dma.h, dma_board.c, fifo_helpers.h, reg_queue_processor.c, reg_queue_processor.h, register_cache.c]
2026-02-10 Drain all pending RX FIFO entries in a single ISR invocation
    Wrap the register_read_irq_isr() body in a while-not-empty loop
    that checks PIO FSTAT, eliminating ~30ns tail-chain overhead per
    re-entry. This fixes a 100% reproducible cold-access failure where
    the WRITE handler's ~300ns execution (branch predictor cold) caused
    the subsequent PREFETCH response to miss the 8088's sampling window.
    [register_irq_handlers.c]
2026-02-12 Fix SD write performance and add SASI reset abort mechanism
    Move f_sync from per-sector to once per WRITE(6) command via new
    storage_sync() API to avoid repeated SD card flushes that caused
    timeouts under sustained I/O. Remove per-sector malloc/free in
    dma_read_from_victor_ram() to eliminate heap fragmentation.
    Add volatile reset_requested flag so Core 0 ISR can signal Core 1
    to abort in-flight read/write commands immediately when the BIOS
    issues a SASI RESET, preventing permanent desync after timeouts.
    [dma.c, dma.h, dma_board.c, register_irq_handlers.c, sasi.c, sd_storage.c, storage.c, storage.h]
2026-02-14 Fix DMA timeout-induced boot failures and cross-core address corruption
    Three main issues addressed:
    1. DMA PIO timeout protection: Replace blocking pio_sm_put/get with
    timeout-protected versions. Prevents permanent Pico deadlock when the
    Victor reboots mid-DMA. Timeout set to 5ms (generous because the 8088
    BIOS timeout counter pauses during DMA HOLD). Emergency abort_dma_transfer()
    cleanly releases bus master and re-enables register SM on timeout.
    2. Cross-core DMA address race: handle_read_sectors() and handle_write_sectors()
    now snapshot dma->dma_address.full into a local variable before the transfer
    loop. Core 0's ISR writes individual bytes to dma_address.bytes.* (ad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
    [dma.c, dma.h, dma_board.c, reg_queue_processor.c, reg_queue_processor.h, register_irq_handlers.c, sasi.c]
2026-02-27 Port SD card robustness, FatFS mutex, and SASI debug from xack_assert
    Ports storage reliability and debugging improvements from the xack_assert
    branch while keeping xack_twice's 3-phase PIO/ISR architecture intact.
    Key changes:
    - Add FatFS cross-core mutex (fatfs_guard) to prevent concurrent FatFS
    corruption between Core 0 log flush and Core 1 sector I/O
    - Move SD card init to Core 1 so SDIO DMA_IRQ_1 registers on Core 1's
    NVIC, eliminating IRQ contention with Core 0's register ISR
    - Lower SDIO DMA_IRQ_1 priority to 0x80 after init so register ISR can
    always preempt
    - Add write retry logic (3 attempts, 5ms delays) and fatal error
    detection with automatic target disable after 50 sust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
    [dma.c, dma.h, dma_board.c, fatfs_guard.c, fatfs_guard.h, hw_config.c, register_cache.c, register_irq_handlers.c]
2026-02-28 Switch SD card from SDIO (PIO2) to hardware SPI1 for reliability
    SDIO mode used PIO2 state machines and DMA_IRQ_1 for SD card access,
    which caused periodic hard errors (FR_DISK_ERR) during sustained writes
    that cascaded into unrecoverable states requiring full remount. Static
    .bss buffers also failed inexplicably while stack buffers worked fine.
    Hardware SPI1 uses the RP2350's dedicated SPI peripheral — no PIO, no
    PIO-based DMA IRQ handler — eliminating the entire class of PIO state
    machine corruption issues. Testing shows zero SD card errors across
    multiple stress test runs (vs frequent failures with SDIO).
    - hw_config.c: Replace sd_sdio_if_t (PIO2/DMA_IRQ_1) with spi_t/sd_sp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
    [dma.h, hw_config.c, register_cache.c, sasi.c, sd_storage.c]
